vmarzlin/ValTronix-KiCad-Libraries/README.md

# ValTronix-KiCad-Libraries
 ValTronix KiCad libraries, includes symbols, footprints and 3D
