vmarzlin/ValTronix-KiCad-Libraries/(commit log)

2020-07-30 Adding Reed Relay SIP-1Axx
2020-10-12 Ajout de commentaires et complément sur les modules et les diodes de puissance
2020-10-12 Correction des modules DC-DC
2020-10-13 Adding P6KExxA TVS diodes serie and some 3D packages
2020-11-05 Transfert des empreintes
    Modification/vérification des empreintes pour que les couches F.Fab et F.CrtYd soient conforme
    Ajout d'optocoupleur anologiques et d'interrupteurs
2021-05-04 Ajout de fusibles
    Ajoute de fusibles et de différents supports
2021-05-04 Modules
    Correction de modules et ajout
2021-05-04 Ajout de jumpers
2021-05-04 Ajout de connecteurs
2021-05-04 Modifications des calques des connecteurs
    Vérification/modification de la couche de fabrication ou de bordure
2021-05-04 Ajout de boîtiers
2021-05-04 Ajout de relais
2021-05-04 Ajout de RFM-xxxx
2021-05-04 Import des composants dans la lib
2021-05-04 Création de modèles de simulation
2021-05-21 Adding 3D for fuses
2021-05-21 Adding relays
2021-08-12 Adding JST and leds
2022-03-28 Ajout de connecteurs, OLED, boutons avec 3D
2022-09-08 Ajout de connecteurs et autres
2022-11-06 Ajout diodes, condensateur, convertisseur DC-DC
2023-04-07 Ajouts massifs
    Connecteurs, convertisseurs CC-CC, LED, relais, interrupteurs...
2025-05-04 Converting to KiCad8
